RefinementReferenceCenter/Modular-MoPSS-Hardware/README.md

# Modular-MoPSS-Hardware

This repository contains the necessary files for 3D printing and to order the ModMoPSS module PCBs (eagle)

(This is a work in progress)

The contents of this repository are distributed under the GNU General Public License v3.0
