RefinementReferenceCenter/Modular-MoPSS-Hardware/PCB design files/ModMoPSS - door module/door fab/bom.xlsx

Comment | Designator | Footprint | JLCPCB Part #（optional）
red | 5V | CHIPLED_0805 | C84256
u33 | C1 | C0805 | C1740
u1 | C2 | C0805 | C49678
100u16v | C3 | SMC_C | C11375
100u16v | C4 | SMC_C | C11375
7805_TO252 | IC1 | TO252 | C233417
red | LED1 | CHIPLED_0805 | C84256
red | LED2 | CHIPLED_0805 | C84256
47k | R1 | R0805 | C17713
47k | R2 | R0805 | C17713
47k | R3 | R0805 | C17713
47k | R4 | R0805 | C17713
47k | R5 | R0805 | C17713
47k | R6 | R0805 | C17713
47k | R7 | R0805 | C17713
15k | R8 | R0805 | C17475
15k | R9 | R0805 | C17475
47k | R10 | R0805 | C17713
47k | R11 | R0805 | C17713
47k | R12 | R0805 | C17713
20k | R13 | R0805 | C4328
47k | R14 | R0805 | C17713
47k | R15 | R0805 | C17713
KH-3635-CAJ | S1 | KH-3635-CAJ | C530670
53261-04 | X1 | 53261-04 | C127368
53261-06 | X2 | 53261-06 | C99277
53261-04 | X3 | 53261-04 | C127368
53261-06 | X4 | 53261-06 | C99277
