RefinementReferenceCenter/Modular-MoPSS-Hardware/PCB design files/ModMoPSS - Hive module A/Hive fab/BOM.xlsx

Comment | Designator | Footprint | JLCPCB Part #（optional）
red | 3V3, 5V, 12V, ERR, STAT | CHIP-LED0805 | C84256
10k | R23, R26, R27 | R0805 | C17414
10u | C5 | C0805 | C15850
15k | R21 | R0805 | C17475
20k | R25 | R0805 | C4328
22k | R13 | R0805 | C17475
30k | R24 | R0805 | C17621
47k | R1, R2, R3, R4, R5, R6, R7, R8, R9, R10, R14, R15, R16, R17, R18, R19 | R0805 | C17713
4k7 | R11, R12, R20 | R0805 | C17673
53048-03 | J1, J2, J3, J4, J5, J6, J7 | 53048-03 | C505275
53048-04 | X1, X2, X3, X4, X5, X6, X7, X8 | 53048-04 | C588275
56k | R22 | R0805 | C17756
BS-08-B2AA002 | BAT | BS-08-B2AA002 | C964790
DC-042C-Z-2.5-A | PWR | DC-042C-Z-2.5-A | C706901
KH-3635-CAJ | B4 | KH-3635-CAJ | C530670
PUSH_BUTTON | B1, B2, B3 | PUSH_BUTTON | C127507
RJ45MAGJACK | ETH | LPJ4012AHNL | C910371
SSD1306 | SSD1306 | SSD1306 | C2718488
TF-011 | SD | TF-011 | C410352
u1 | C2, C3, C4 | C0805 | C49678
u33 | C1 | C0805 | C1740
uA7805CKCS | IC1 | TO252 | C233417
