RefinementReferenceCenter/Modular-MoPSS-Hardware/PCB design files/ModMoPSS - IR sender P/IR sen P fab/BOM.xlsx

Comment | Designator | Footprint | JLCPCB Part #（optional）
IR17-21C/TR8 | BOTTOM | CHIP-LED0805 | C131250
VSMB14940 | IRS1 | VSMB14940 | C511069
VSMB14940 | IRS2 | VSMB14940 | C511069
53261-04 | J1 | 53261-04 | C127368
PT12-21B/TR8 | PTS1 | PT12-21B/TR8 | C264383
PT12-21B/TR8 | PTS2 | PT12-21B/TR8 | C264383
1k 1/4W | R1 | R0805 | C412430
1k 1/4W | R2 | R0805 | C412430
2k | R3 | R0805 | C17604
2k | R4 | R0805 | C17604
IR17-21C/TR8 | TOP | CHIP-LED0805 | C131250
