RefinementReferenceCenter/Modular-MoPSS-Hardware/PCB design files/ModMoPSS - RFID module/RFID fab/BOM.xlsx

Comment | Designator | Footprint | JLCPCB Part #（optional）
red | 5V, READ1, READ2, STAT1, STAT2 | CHIPLED_0805 | C84256
100R 100V | R5, R7 | R1206 | C17901
100nF | C3, C4, C14, C26, C28, C30 | R1206 | C24497
100u 6.3V | C5, C6, C7, C10, C34, C35, C36, C40 | R1206 | C15008
10n | C8, C38 | R1206 | C1846
10nF | C15, C16, C25, C31 | R1206 | C1846
10u 16V | C9, C39 | R1206 | C2911415
1500p NP0 | C13, C20 | R1206 | C309500
1k | R6, R12, R14, R15 | R0805 | C17513
1k8 | R2, R4, R8, R11 | R0805 | C17398
1nF | C1, C2, C17, C27, C29, C32 | R1206 | C9196
1uF | C18, C33 | R1206 | C1848
20k | R13 | R0805 | C4328
390p NP0 100V | C21, C37 | R1206 | C527300
39p NP0 100V | C19, C24 | R1206 | C527287
3k3 | R1, R3, R9, R10 | R0805 | C26010
53048-02 | ANT1, ANT2 | 53048-02 | C505099
56p NP0 100V | C22, C44 | R1206 | C527289
5V6 | D1, D2 | SOD80C | C8062
7805_TO252 | IC2 | TO252 | C233417
EM4095 | IC3, IC4 | SO16 | C11356
JZ300HV | C23, C41 | JZ300HV
KH-3635-CAJ | S1, S2 | KH-3635-CAJ | C530670
LT1761ES5-5 | IC1, IC5 | TSOT23-5 | C117230
u1 | C12 | C0805 | C49678
u33 | C11 | C0805 | C1740
