RefinementReferenceCenter/Modular-MoPSS-Hardware/PCB design files/ModMoPSS - IR receiver P/IR rec P fab/BOM.xlsx

Comment | Designator | Footprint | JLCPCB Part #（optional）
PT11-21C/L41/TR8 | BOTTOM | CHIPLED_1206 | C16746
VSMB14940 | IRS1 | VSMB14940 | C511069
VSMB14940 | IRS2 | VSMB14940 | C511069
PT12-21B/TR8 | PTS1 | PT12-21B/TR8 | C264383
PT12-21B/TR8 | PTS2 | PT12-21B/TR8 | C264383
1k 1/4W | R1 | R0805 | C412430
1k 1/4W | R2 | R0805 | C412430
PT11-21C/L41/TR8 | TOP | CHIPLED_1206 | C16746
53261-06 | X1 | 53261-06 | C99277
