RefinementReferenceCenter/Modular-MoPSS-Hardware/3D print files/ModMoPSS case/RFIDcase.stl

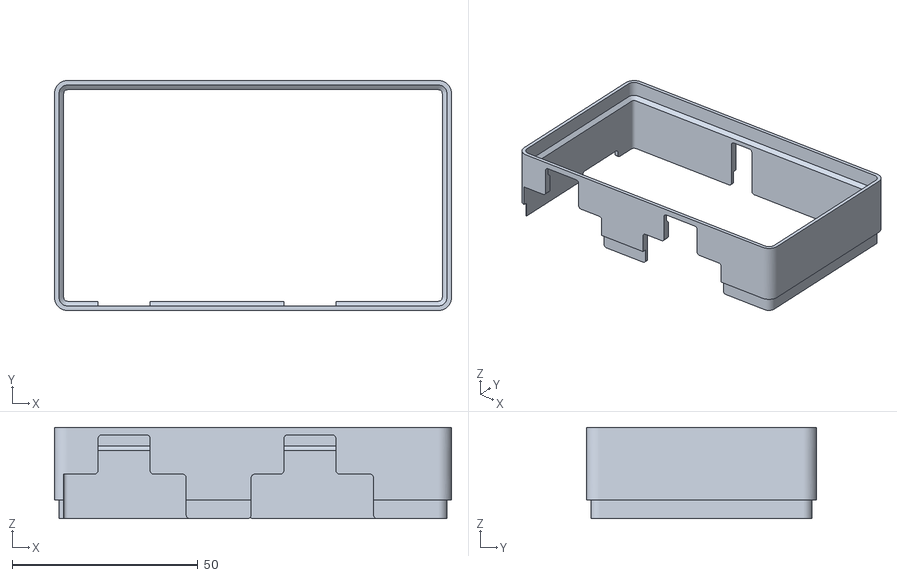
[picture p1: CAD file, 2023-12-20]
3D print files/ModMoPSS case/RFIDcase.stl
107.0 x 62.0 x 24.6
