RefinementReferenceCenter/Modular-MoPSS-Hardware/3D print files/ModMoPSS Gate parts/Motorholder 40mm.stl

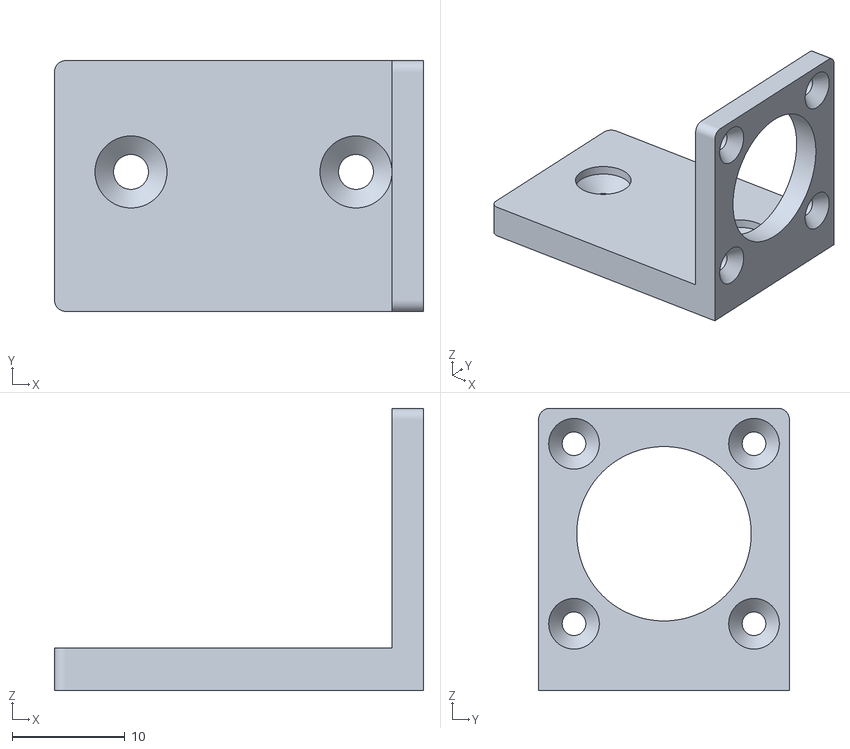
[picture p2: CAD file, 2023-11-22]
3D print files/ModMoPSS Gate parts/Motorholder 40mm.stl
32.8 x 22.3 x 25.1
