RefinementReferenceCenter/Modular-MoPSS-Hardware/3D print files/ModMoPSS case/Buttonextension.stl

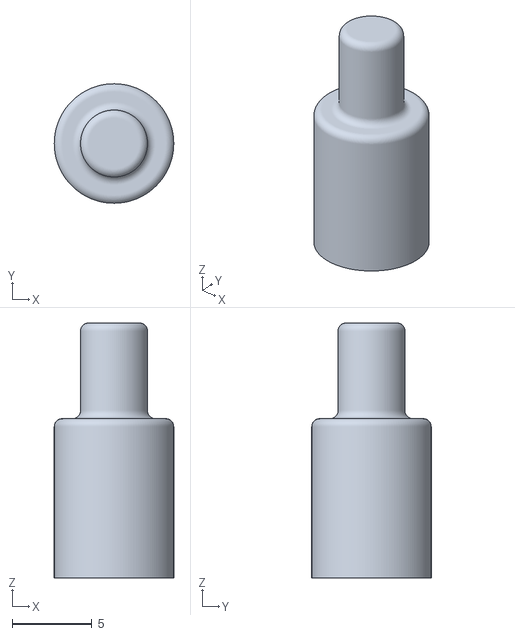
[picture p3: CAD file, 2023-02-16]
3D print files/ModMoPSS case/Buttonextension.stl
7.50 x 7.50 x 16.0
