RefinementReferenceCenter/Modular-MoPSS-Hardware/3D print files/ModMoPSS Gate parts/clamp 40mm.stl

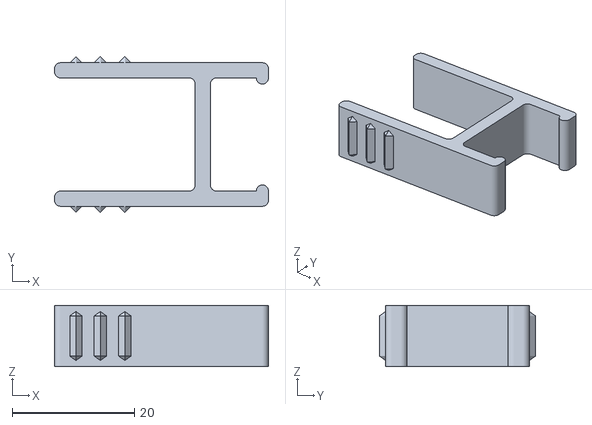
[picture p4: CAD file, 2023-11-22]
3D print files/ModMoPSS Gate parts/clamp 40mm.stl
35.0 x 25.5 x 10.0
