RefinementReferenceCenter/Modular-MoPSS-Hardware/3D print files/ModMoPSS case/Bottom.stl

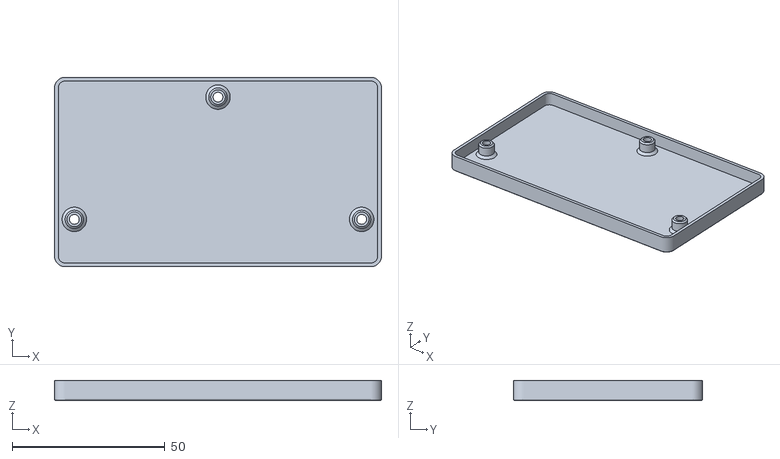
[picture p5: CAD file, 2023-02-14]
3D print files/ModMoPSS case/Bottom.stl
107.0 x 62.0 x 6.60
