RefinementReferenceCenter/Modular-MoPSS-Hardware/3D print files/ModMoPSS Gate parts/Door A 40mm.stl

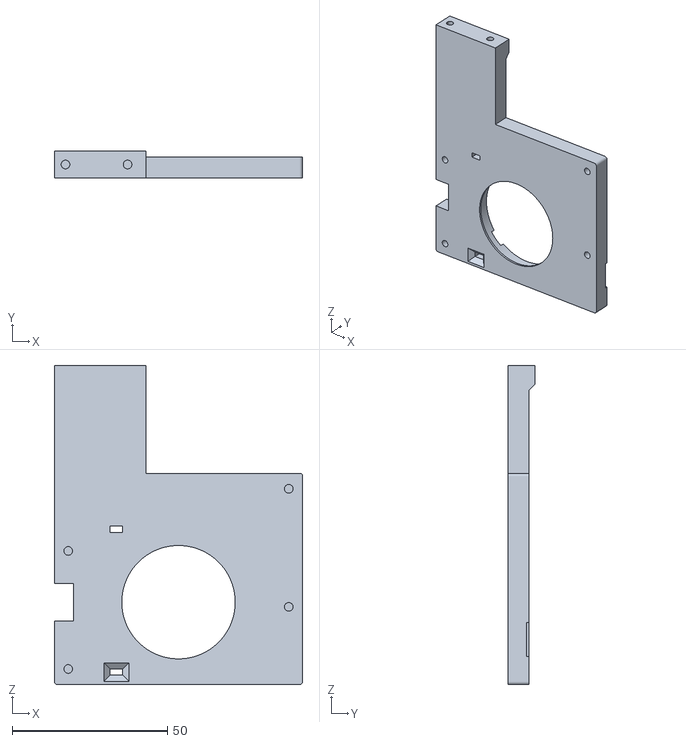
[picture p6: CAD file, 2023-11-22]
3D print files/ModMoPSS Gate parts/Door A 40mm.stl
80.0 x 8.80 x 102.7
