RefinementReferenceCenter/Modular-MoPSS-Hardware/3D print files/ModMoPSS case/Steppercase.stl

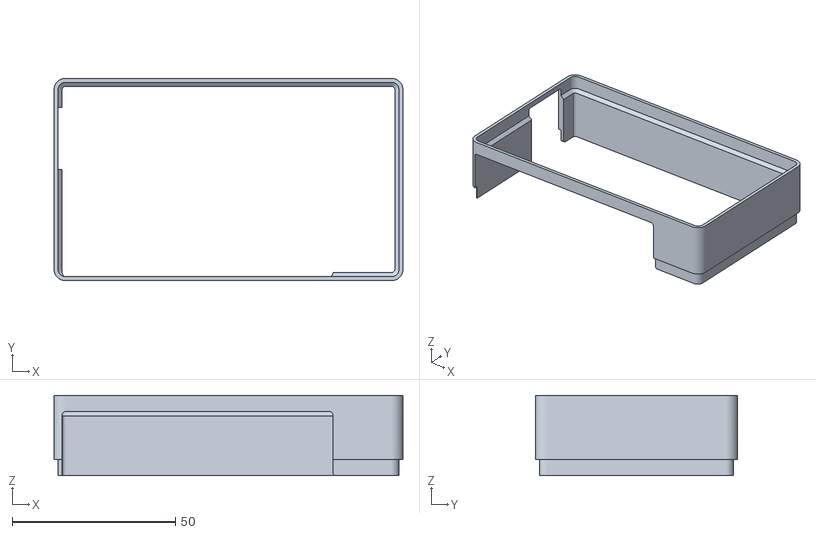
[picture p7: CAD file, 2023-02-14]
3D print files/ModMoPSS case/Steppercase.stl
107.0 x 62.0 x 24.6
