RefinementReferenceCenter/Modular-MoPSS-Hardware/3D print files/ModMoPSS Gate parts/Door 40mm.stl

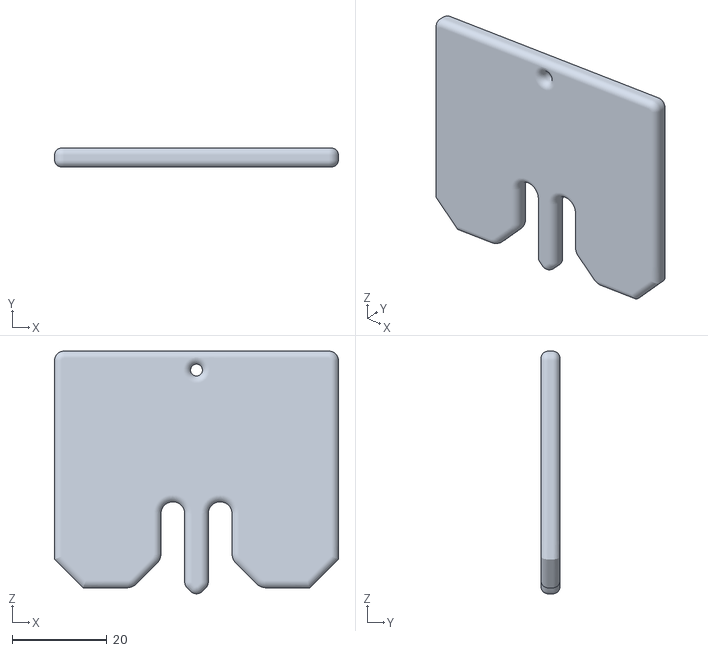
[picture p8: CAD file, 2023-11-22]
3D print files/ModMoPSS Gate parts/Door 40mm.stl
60.0 x 4.00 x 51.3
