RefinementReferenceCenter/Modular-MoPSS-Hardware/3D print files/ModMoPSS Gate parts/Door B 40mm.stl

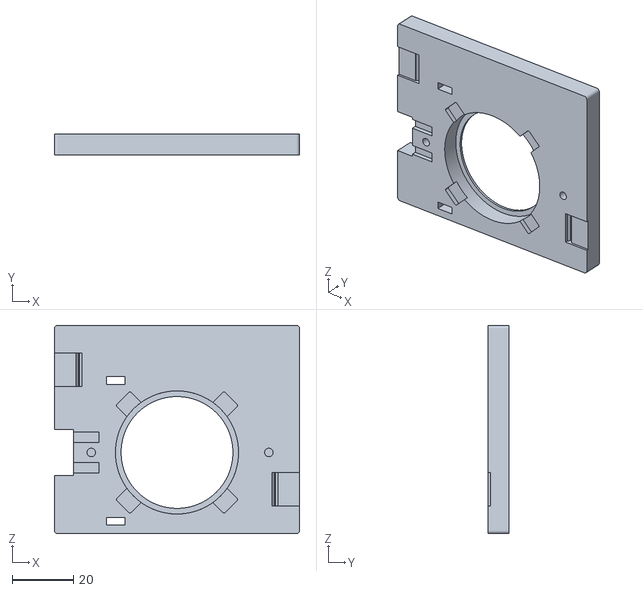
[picture p10: CAD file, 2023-11-22]
3D print files/ModMoPSS Gate parts/Door B 40mm.stl
80.0 x 6.80 x 68.0
