RefinementReferenceCenter/Modular-MoPSS-Hardware/3D print files/ModMoPSS Gate parts/door 30mm.stl

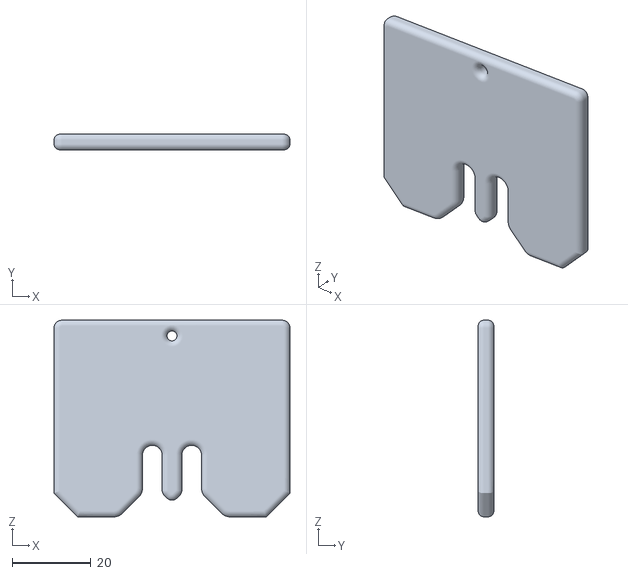
[picture p12: CAD file, 2023-01-30]
3D print files/ModMoPSS Gate parts/door 30mm.stl
60.0 x 4.00 x 50.0
