RefinementReferenceCenter/Modular-MoPSS-Hardware/3D print files/ModMoPSS Gate parts/door part D.stl

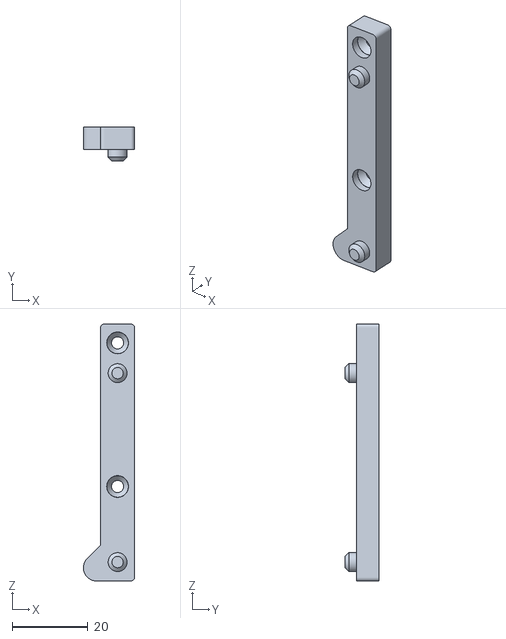
[picture p13: CAD file, 2023-01-30]
3D print files/ModMoPSS Gate parts/door part D.stl
13.6 x 9.00 x 68.0
