RefinementReferenceCenter/Modular-MoPSS-Hardware/3D print files/ModMoPSS Gate parts/door part B 30mm.stl

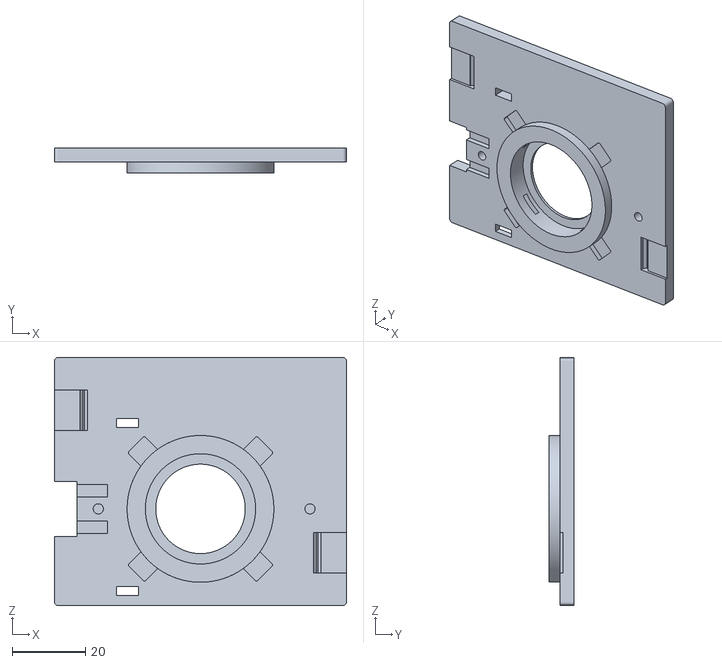
[picture p14: CAD file, 2023-01-30]
3D print files/ModMoPSS Gate parts/door part B 30mm.stl
80.0 x 6.80 x 68.0
