RefinementReferenceCenter/Modular-MoPSS-Hardware/3D print files/ModMoPSS Gate parts/spool.stl

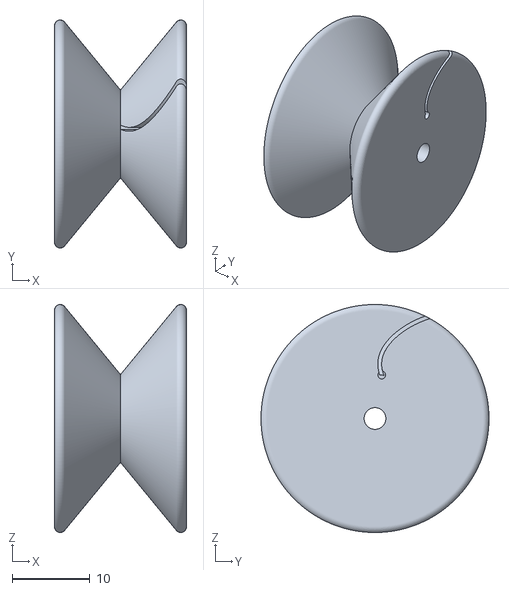
[picture p15: CAD file, 2023-01-30]
3D print files/ModMoPSS Gate parts/spool.stl
17.0 x 29.3 x 29.3
