RefinementReferenceCenter/Modular-MoPSS-Hardware/3D print files/ModMoPSS Gate parts/door part A 30mm.stl

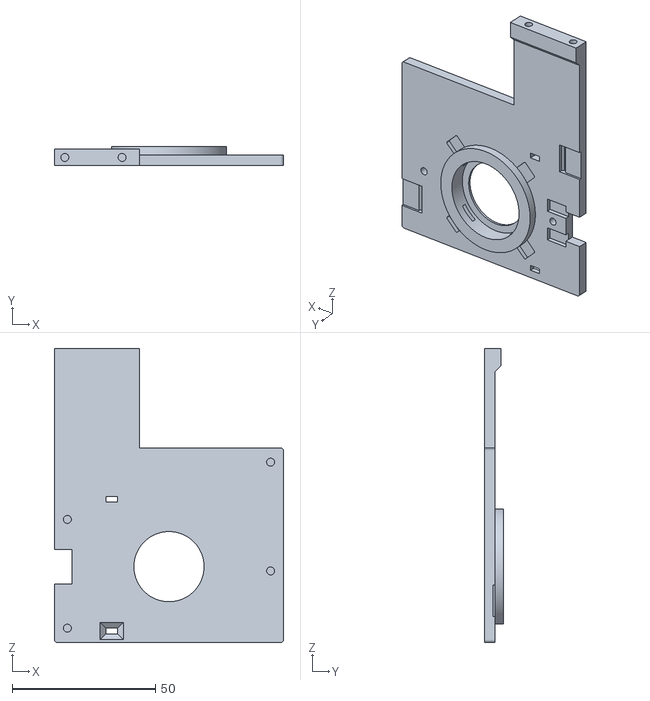
[picture p16: CAD file, 2023-01-30]
3D print files/ModMoPSS Gate parts/door part A 30mm.stl
80.0 x 6.80 x 102.7
