RefinementReferenceCenter/Modular-MoPSS-Hardware/3D print files/ModMoPSS Gate parts/clamp 30mm.stl

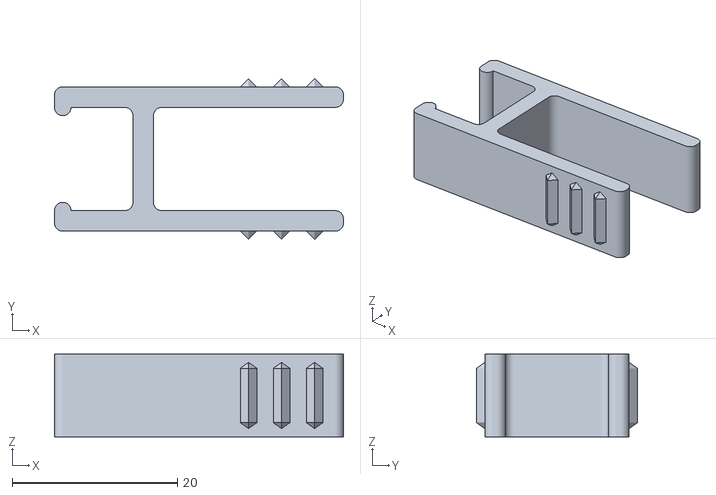
[picture p17: CAD file, 2023-01-30]
3D print files/ModMoPSS Gate parts/clamp 30mm.stl
35.0 x 19.5 x 10.0
