RefinementReferenceCenter/Modular-MoPSS-Hardware/(list of files, cad)

Other CAD files:
3D print files/ModMoPSS Gate parts/door part C.stl
3D print files/ModMoPSS Gate parts/motorholder 30mm.stl
