RefinementReferenceCenter/Modular-MoPSS-Hardware/PCB design files/ModMoPSS - RFID module/rfid.brd

## EAGLE design PCB design files/ModMoPSS - RFID module/rfid.brd (2025-07-09)

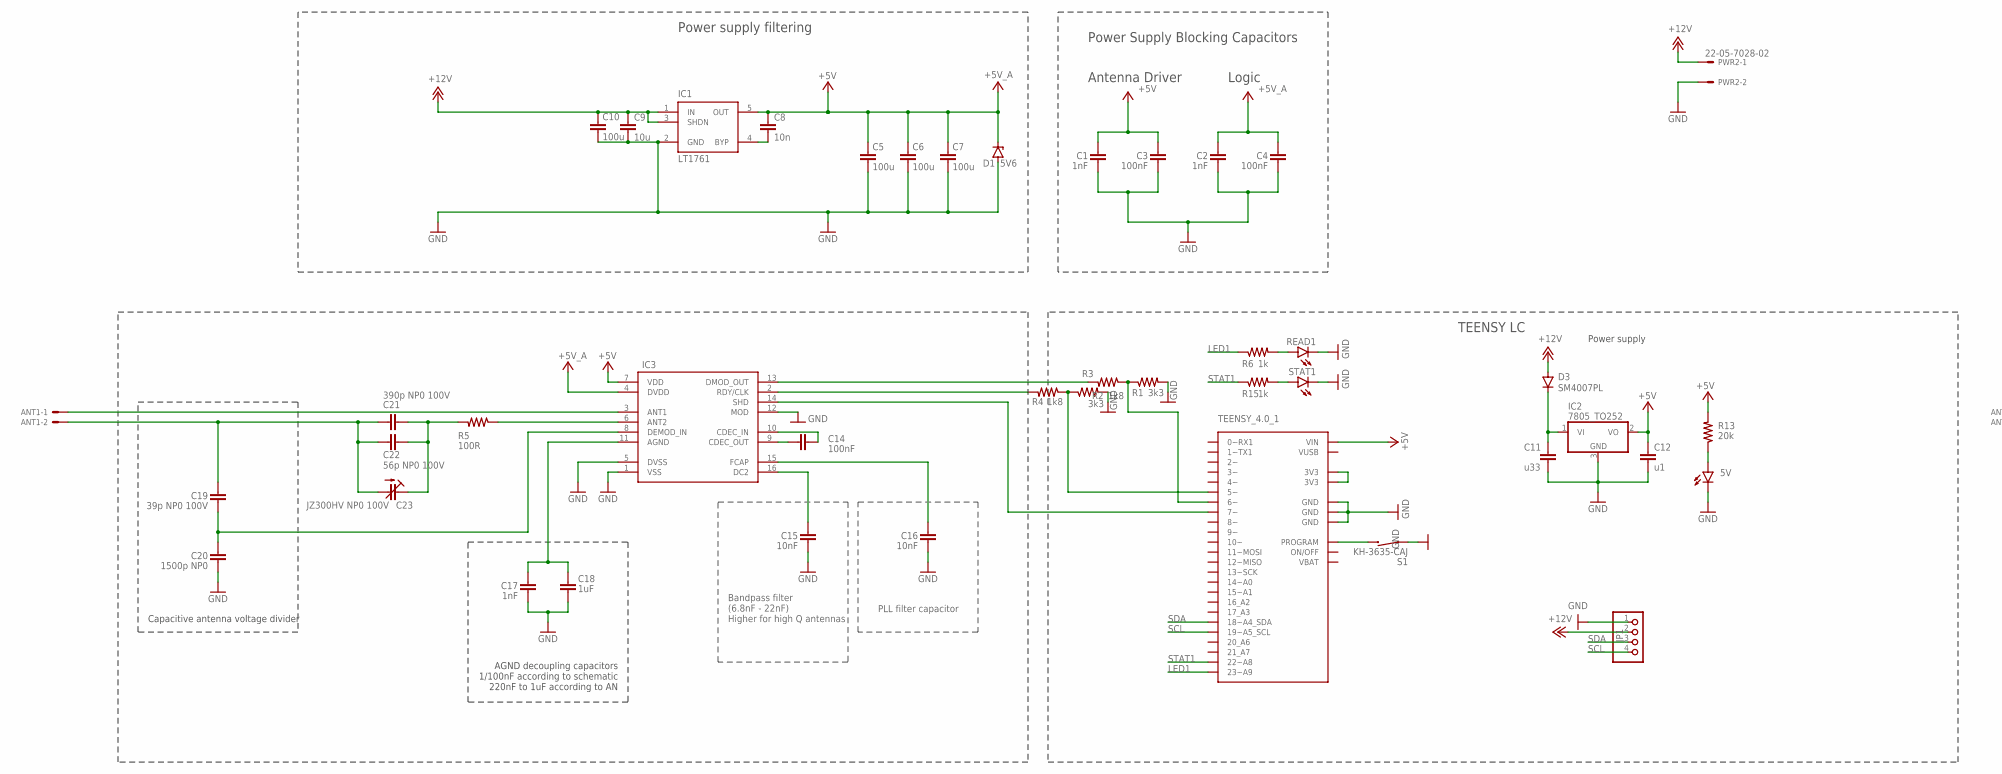
[picture p18: schematic rfid.sch, part in row 1, column 1]

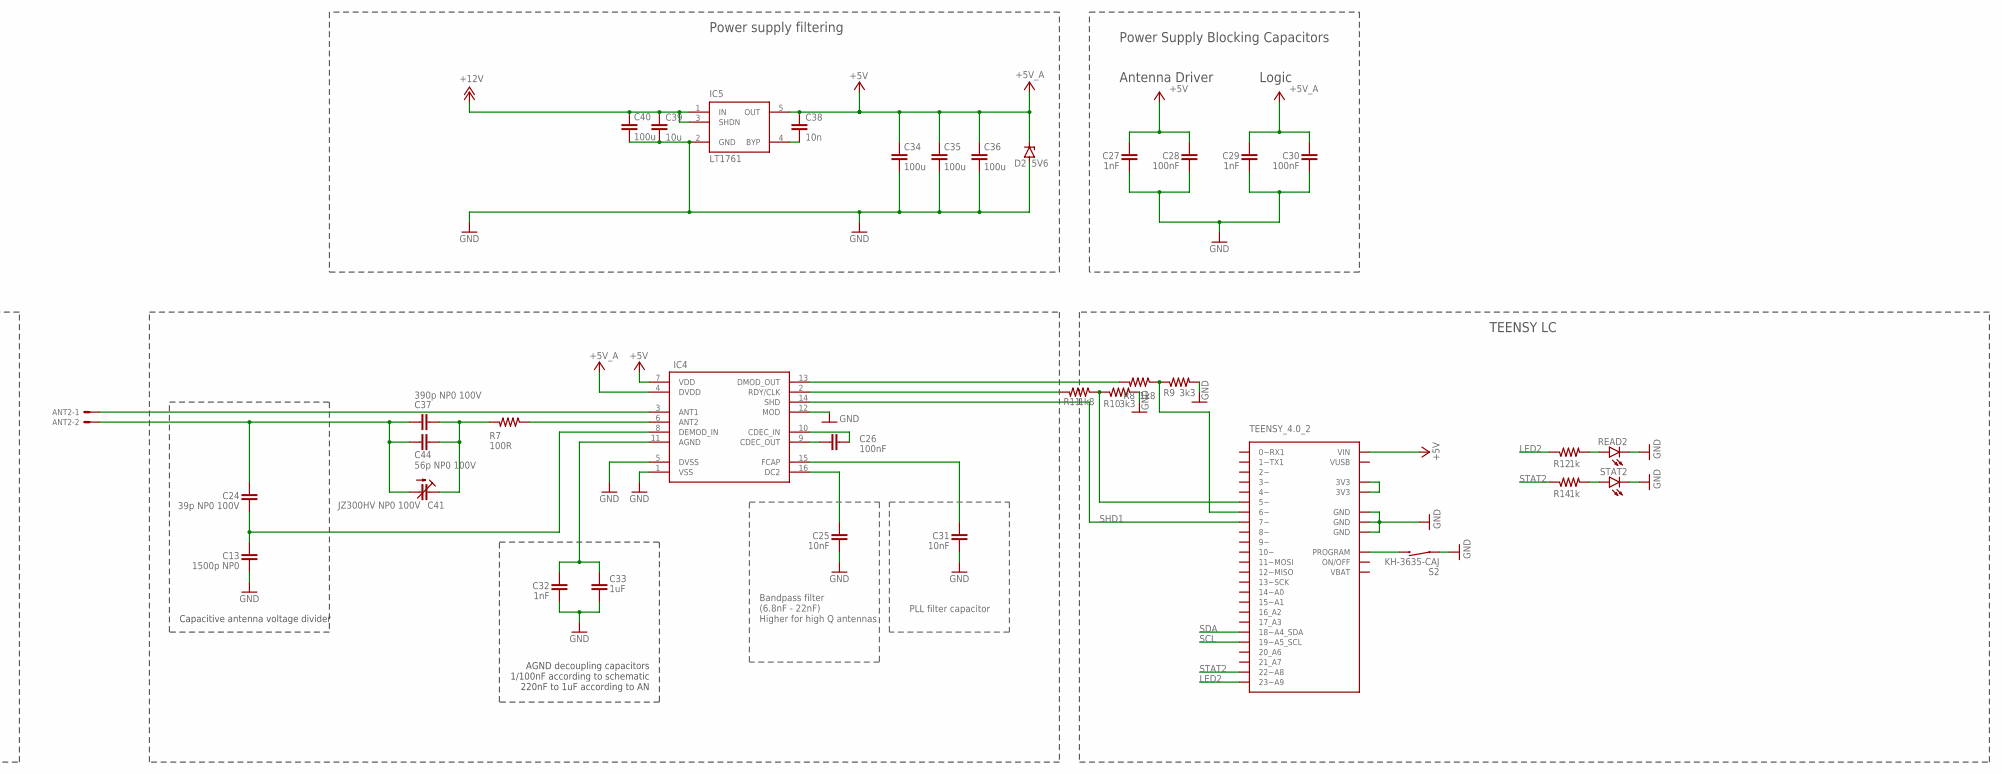
[picture p19: schematic rfid.sch, part in row 1, column 2]

Parts:
5V: LEDCHIPLED_0805; CHIPLED_0805
ANT1, ANT2: 53261-02
C1, C2, C17, C27, C29, C32: 1nF; R1206
C3, C4, C14, C26, C28, C30: 100nF; R1206
C5, C6, C7, C10, C34, C35, C36, C40: 100u; R1206
C8, C38: 10n; R1206
C9, C39: 10u; R1206
C11: u33; C0805
C12: u1; C0805
C13, C20: 1500p NP0; R1206
C15, C16, C25, C31: 10nF; R1206
C18, C33: 1uF; R1206
C19, C24: 39p NP0 100V; R1206
C21, C37: 390p NP0 100V; R1206
C22, C44: 56p NP0 100V; R1206
C23, C41: JZ300HV NP0 100V; JZ300HV
D1, D2: 5V6; SOD80C
D3: SM4007PL; SOD-123_MINI-SMA
IC1, IC5: LT1761; TSOT23-5
IC2: 7805_TO252; TO252
IC3, IC4: EM4095; SO16
JP1: PINHD-1X4; 1X04
PWR2: 22-05-7028-02; 7395-02
R1, R3, R9, R10: 3k3; R0805
R2, R4, R8, R11: 1k8; R0805
R5, R7: 100R; R1206
R6, R12, R14, R15: 1k; R0805
R13: 20k; R0805
READ1, READ2: LEDCHIPLED_0805; CHIPLED_0805
S1, S2: KH-3635-CAJ
STAT1, STAT2: LEDCHIPLED_0805; CHIPLED_0805
TEENSY_4.0_1, TEENSY_4.0_2: TEENSY40

Connections:
+5V: C1.2, C2.2, C3.2, C4.2, C5.1, C6.1, C7.1, C8.1, C12.1, C27.2, C28.2, C29.2, C30.2, C34.1, C35.1, C36.1, C38.1, D1.C, D2.C, IC1.5 (OUT), IC2.2 (VO), IC3.4 (DVDD), IC3.7 (VDD), IC4.4 (DVDD), IC4.7 (VDD), IC5.5 (OUT), R13.2, TEENSY_4.0_1.VIN, TEENSY_4.0_2.VIN
+12V: C9.1, C10.1, C39.1, C40.1, D3.A, IC1.1 (IN), IC1.3 (SHDN), IC5.1 (IN), IC5.3 (SHDN), JP1.2, PWR2.1
AGND: C17.2, C18.2, IC3.11 (AGND)
AGND1: C32.2, C33.2, IC4.11 (AGND)
ANT2: IC3.6 (ANT2), R5.1
ANT3: IC4.6 (ANT2), R7.1
ANT4: ANT2.1, IC4.3 (ANT1)
CDEC_IN: C14.2, IC3.10 (CDEC_IN)
CDEC_IN1: C26.2, IC4.10 (CDEC_IN)
CDEC_OUT: C14.1, IC3.9 (CDEC_OUT)
CDEC_OUT1: C26.1, IC4.9 (CDEC_OUT)
DC1: C25.1, IC4.16 (DC2)
DC2: C15.1, IC3.16 (DC2)
DMODI: C19.1, C20.2, IC3.8 (DEMOD_IN)
DMODI1: C13.2, C24.1, IC4.8 (DEMOD_IN)
FCAP: C16.1, IC3.15 (FCAP)
FCAP1: C31.1, IC4.15 (FCAP)
GND: 5V.C, C1.1, C2.1, C3.1, C4.1, C5.2, C6.2, C7.2, C9.2, C10.2, C11.2, C12.2, C13.1, C15.2, C16.2, C17.1, C18.1, C20.1, C25.2, C27.1, C28.1, C29.1, C30.1, C31.2, C32.1, C33.1, C34.2, C35.2, C36.2, C39.2, C40.2, D1.A, D2.A, IC1.2 (GND), IC2.3 (GND), IC3.1 (VSS), IC3.5 (DVSS), IC3.12 (MOD), IC4.1 (VSS), IC4.5 (DVSS), IC4.12 (MOD), IC5.2 (GND), JP1.1, PWR2.2, R1.2, R3.2, R9.2, R10.2, READ1.C, READ2.C, S1.P$1 (1), S2.P$1 (1), STAT1.C, STAT2.C, TEENSY_4.0_1.GND, TEENSY_4.0_1.GND@1 (GND), TEENSY_4.0_1.GND@2 (GND), TEENSY_4.0_2.GND, TEENSY_4.0_2.GND@1 (GND), TEENSY_4.0_2.GND@2 (GND)
LED1: R6.1, TEENSY_4.0_1.23 (23~A9)
LED2: R12.1, TEENSY_4.0_2.23 (23~A9)
unnamed: R6.2, READ1.A
unnamed: R3.1, R4.1, TEENSY_4.0_1.5 (5~)
unnamed: ANT2.2, C24.2, C37.1, C41.P$1 (A), C44.1
unnamed: C37.2, C41.P$2 (E), C44.2, R7.2
unnamed: C21.2, C22.2, C23.P$2 (E), R5.2
unnamed: R1.1, R2.1, TEENSY_4.0_1.6 (6~)
unnamed: C8.2, IC1.4 (BYP)
unnamed: S1.P$2 (2), TEENSY_4.0_1.PROG (PROGRAM)
unnamed: C38.2, IC5.4 (BYP)
unnamed: TEENSY_4.0_1.3V3, TEENSY_4.0_1.3V3@2 (3V3)
unnamed: R8.1, R9.1, TEENSY_4.0_2.6 (6~)
unnamed: R10.1, R11.1, TEENSY_4.0_2.5 (5~)
unnamed: R12.2, READ2.A
unnamed: ANT1.2, C19.2, C21.1, C22.1, C23.P$1 (A)
unnamed: IC3.14 (SHD), TEENSY_4.0_1.7 (7~)
unnamed: S2.P$2 (2), TEENSY_4.0_2.PROG (PROGRAM)
unnamed: TEENSY_4.0_2.3V3, TEENSY_4.0_2.3V3@2 (3V3)
unnamed: R14.2, STAT2.A
unnamed: R15.2, STAT1.A
unnamed: ANT1.1, IC3.3 (ANT1)
unnamed: C11.1, D3.C, IC2.1 (VI)
unnamed: IC4.13 (DMOD_OUT), R8.2
unnamed: IC3.2 (RDY/CLK), R4.2
unnamed: IC3.13 (DMOD_OUT), R2.2
unnamed: 5V.A, R13.1
unnamed: IC4.2 (RDY/CLK), R11.2
SCL: JP1.4, TEENSY_4.0_1.19 (19~A5_SCL), TEENSY_4.0_2.19 (19~A5_SCL)
SDA: JP1.3, TEENSY_4.0_1.18 (18~A4_SDA), TEENSY_4.0_2.18 (18~A4_SDA)
SHD1: IC4.14 (SHD), TEENSY_4.0_2.7 (7~)
STAT1: R15.1, TEENSY_4.0_1.22 (22~A8)
STAT2: R14.1, TEENSY_4.0_2.22 (22~A8)

Notes on the sheet:
Power supply filtering
Antenna Driver
Logic
AGND decoupling capacitors 1/100nF according to schematic 220nF to 1uF according to AN
Capacitive antenna voltage divider
Bandpass filter (6.8nF - 22nF) Higher for high Q antennas
PLL filter capacitor
Power Supply Blocking Capacitors
TEENSY LC
Power supply

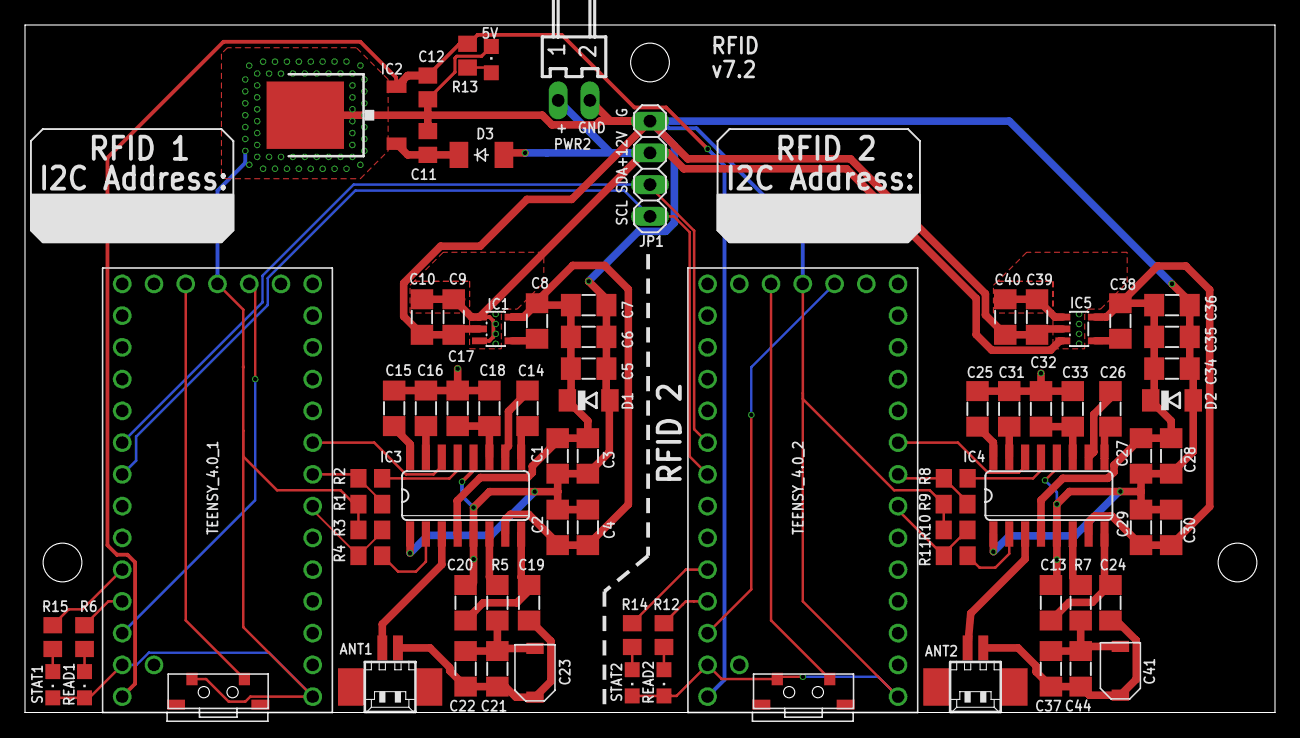
[picture p20: board rfid.brd from above]

Board: 2 copper layers, 100.0 x 55.0 mm, 78 parts (0 on the bottom side), 51 nets.
