RefinementReferenceCenter/Modular-MoPSS-Hardware/PCB design files/ModMoPSS - Hive module A/hive_module.brd

## EAGLE design PCB design files/ModMoPSS - Hive module A/hive_module.brd (2023-01-10)

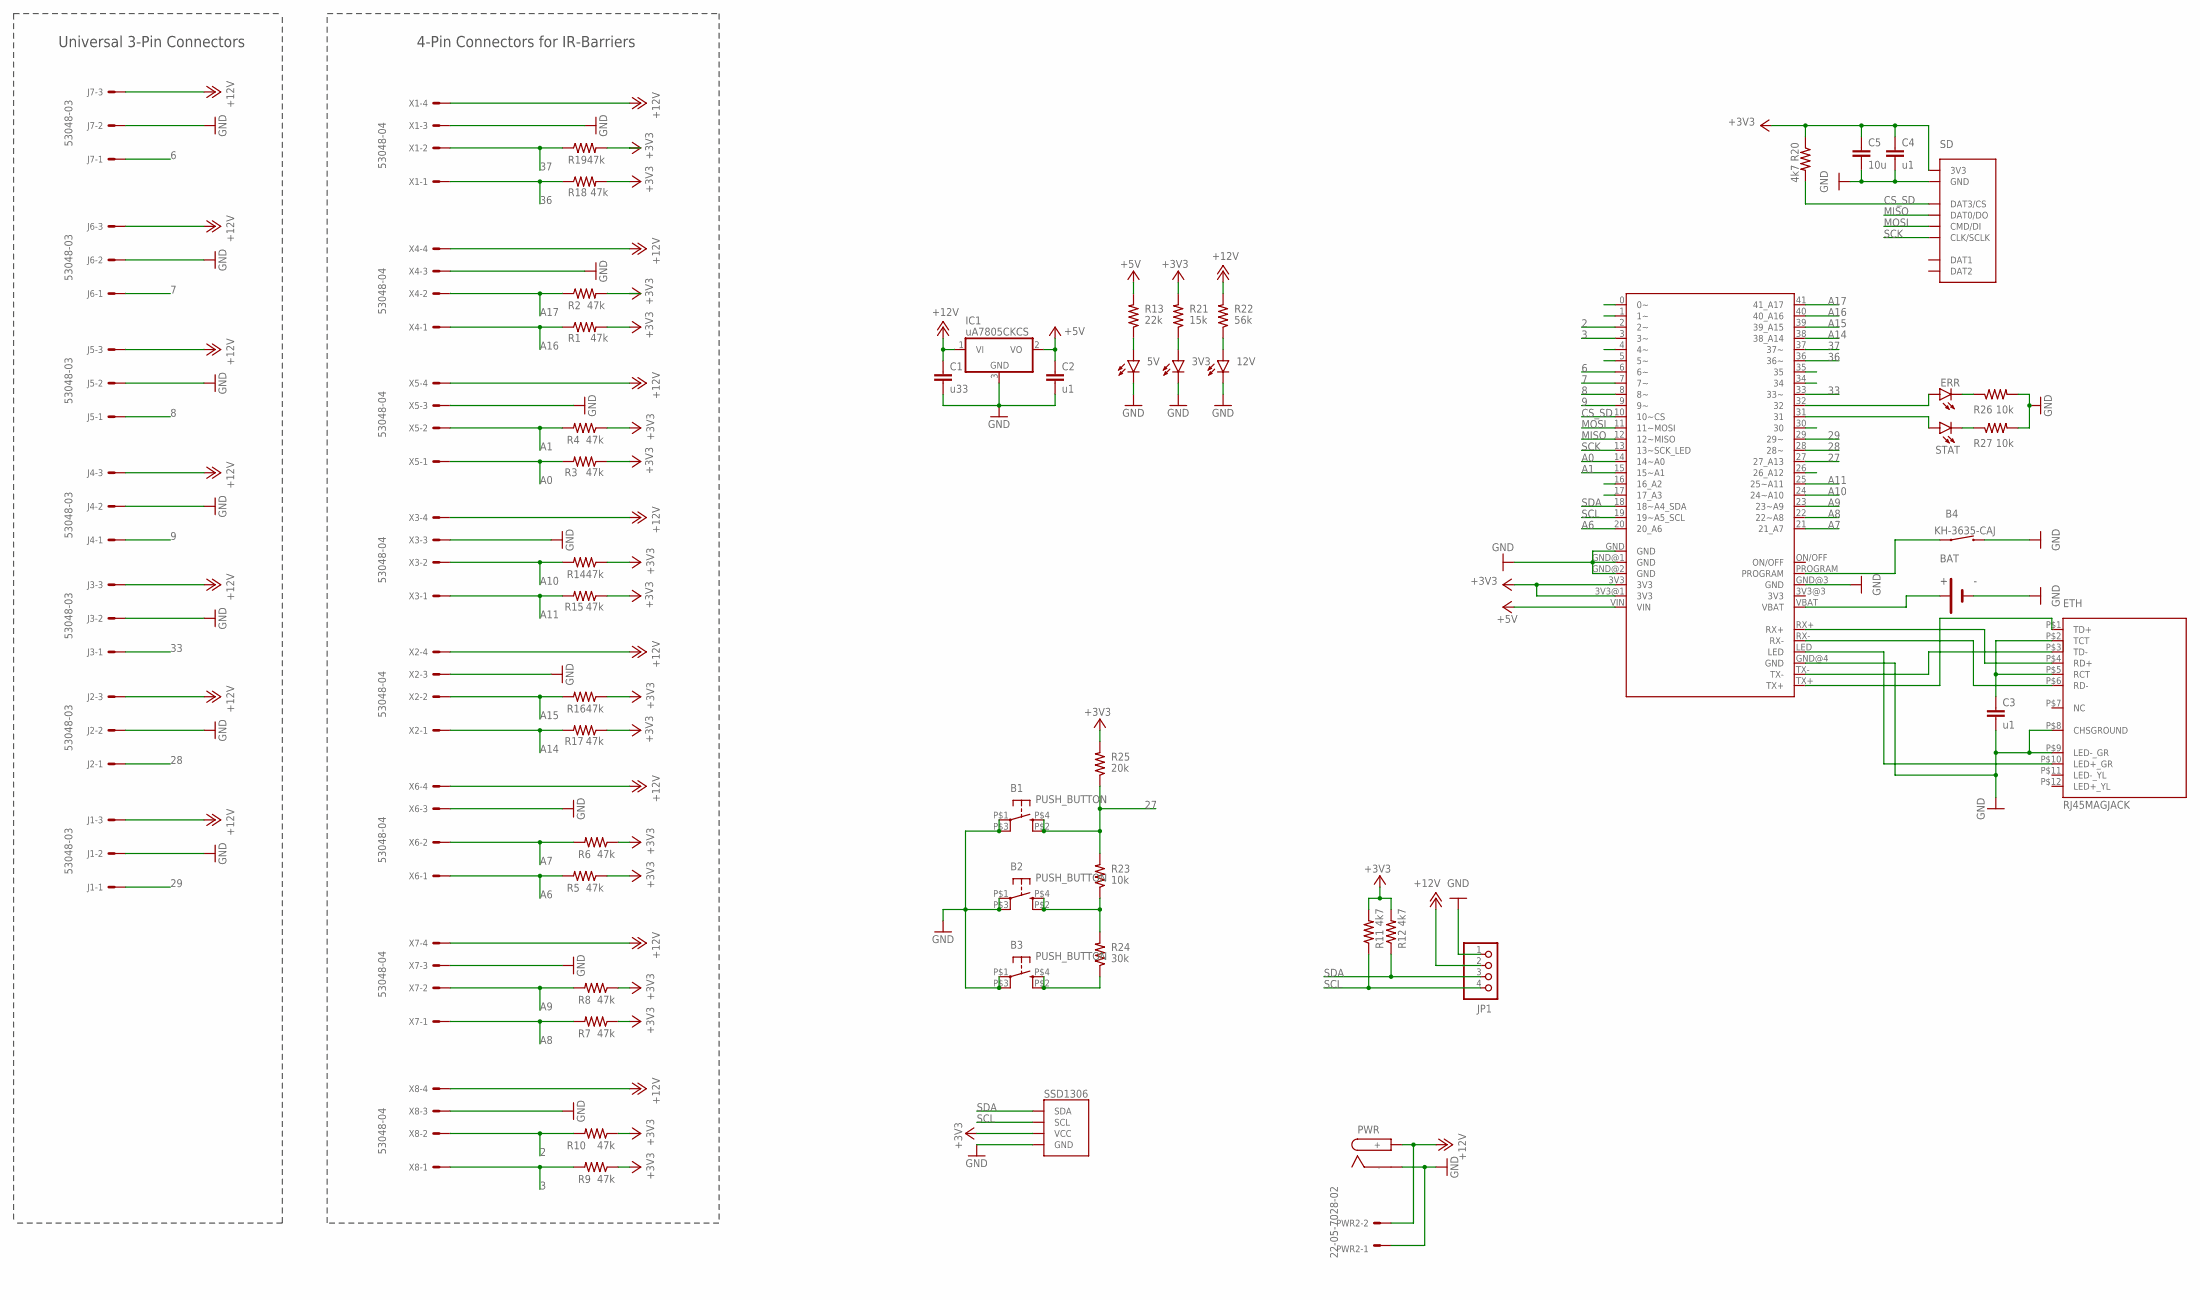
[picture p21: schematic hive_module.sch]

Parts:
3V3, 5V, 12V: LEDCHIP-LED0805; CHIP-LED0805
B1, B2, B3: PUSH_BUTTON
B4: KH-3635-CAJ
BAT: BS-08-B2AA002
C1: u33; C0805
C2, C3, C4: u1; C0805
C5: 10u; C0805
ERR: LEDCHIP-LED0805; CHIP-LED0805
ETH: RJ45MAGJACK; LPJ4012AHNL
IC1: uA7805CKCS; TO252
J1, J2, J3, J4, J5, J6, J7: 53048-03
JP1: PINHD-1X4; 1X04
PWR: DC-042C-Z-2.5-A
PWR2: 22-05-7028-02; 7395-02
R1, R2, R3, R4, R5, R6, R7, R8, R9, R10, R14, R15, R16, R17, R18, R19: 47k; R0805
R11, R12, R20: 4k7; R0805
R13: 22k; R0805
R21: 15k; R0805
R22: 56k; R0805
R23, R26, R27: 10k; R0805
R24: 30k; R0805
R25: 20k; R0805
SD: TF-011
SSD1306: SSD1306
STAT: LEDCHIP-LED0805; CHIP-LED0805
U$1: TEENSY41
X1, X2, X3, X4, X5, X6, X7, X8: 53048-04

Connections:
2: R10.2, U$1.2 (2~), X8.2
3: R9.2, U$1.3 (3~), X8.1
6: J7.1, U$1.6 (6~)
7: J6.1, U$1.7 (7~)
8: J5.1, U$1.8 (8~)
9: J4.1, U$1.9 (9~)
27: B1.P$2 (S1), B1.P$4 (S), R23.2, R25.1, U$1.27 (27_A13)
28: J2.1, U$1.28 (28~)
29: J1.1, U$1.29 (29~)
33: J3.1, U$1.33 (33~)
36: R18.1, U$1.36 (36~), X1.1
37: R19.1, U$1.37 (37~), X1.2
+3V3: C4.1, C5.1, R1.2, R2.2, R3.1, R4.1, R5.1, R6.1, R7.1, R8.1, R9.1, R10.1, R11.2, R12.2, R14.1, R15.1, R16.1, R17.1, R18.2, R19.2, R20.1, R21.2, R25.2, SD.P$4 (3V3), SSD1306.P$2 (VCC), U$1.3V3, U$1.3V3@1 (3V3)
+5V: C2.1, IC1.2 (VO), R13.2, U$1.VIN
+12V: C1.1, IC1.1 (VI), J1.3, J2.3, J3.3, J4.3, J5.3, J6.3, J7.3, JP1.2, PWR.P$6 (+), PWR2.2, R22.2, X1.4, X2.4, X3.4, X4.4, X5.4, X6.4, X7.4, X8.4
A0: R3.2, U$1.14 (14~A0), X5.1
A1: R4.2, U$1.15 (15~A1), X5.2
A6: R5.2, U$1.20 (20_A6), X6.1
A7: R6.2, U$1.21 (21_A7), X6.2
A8: R7.2, U$1.22 (22~A8), X7.1
A9: R8.2, U$1.23 (23~A9), X7.2
A10: R14.2, U$1.24 (24~A10), X3.2
A11: R15.2, U$1.25 (25~A11), X3.1
A14: R17.2, U$1.38 (38_A14), X2.1
A15: R16.2, U$1.39 (39_A15), X2.2
A16: R1.1, U$1.40 (40_A16), X4.1
A17: R2.1, U$1.41 (41_A17), X4.2
CS_SD: R20.2, SD.P$2 (DAT3/CS), U$1.10 (10~CS)
GND: 3V3.C, 5V.C, 12V.C, B1.P$1, B1.P$3 (P1), B2.P$1, B2.P$3 (P1), B3.P$1, B3.P$3 (P1), B4.P$2 (2), BAT.-, C1.2, C2.2, C3.2, C4.2, C5.2, ETH.P$8 (CHSGROUND), ETH.P$9 (LED-_GR), IC1.3 (GND), J1.2, J2.2, J3.2, J4.2, J5.2, J6.2, J7.2, JP1.1, PWR.P$1 (-), PWR.P$2 (-), PWR.P$3 (-), PWR.P$4 (-), PWR.P$5 (-), PWR2.1, R26.2, R27.2, SD.P$6 (GND), SD.P$9 (GND), SD.P$10 (GND), SD.P$11 (GND), SD.P$12 (GND), SSD1306.P$1 (GND), U$1.GND, U$1.GND@1 (GND), U$1.GND@2 (GND), U$1.GND@3 (GND), U$1.GND@4 (GND), X1.3, X2.3, X3.3, X4.3, X5.3, X6.3, X7.3, X8.3
MISO: SD.P$7 (DAT0/DO), U$1.12 (12~MISO)
MOSI: SD.P$3 (CMD/DI), U$1.11 (11~MOSI)
unnamed: ETH.P$1 (TD+), U$1.TX+
unnamed: ETH.P$3 (TD-), U$1.TX-
unnamed: 3V3.A, R21.1
unnamed: ETH.P$6 (RD-), U$1.RX-
unnamed: ETH.P$4 (RD+), U$1.RX+
unnamed: ETH.P$10 (LED+_GR), U$1.LED
unnamed: 12V.A, R22.1
unnamed: C3.1, ETH.P$2 (TCT), ETH.P$5 (RCT)
unnamed: BAT.+, U$1.VBAT
unnamed: B4.P$1 (1), U$1.PROGRAM
unnamed: ERR.A, U$1.32
unnamed: B3.P$2 (S1), B3.P$4 (S), R24.1
unnamed: B2.P$2 (S1), B2.P$4 (S), R23.1, R24.2
unnamed: ERR.C, R26.1
unnamed: R27.1, STAT.C
unnamed: STAT.A, U$1.31
unnamed: 5V.A, R13.1
SCK: SD.P$5 (CLK/SCLK), U$1.13 (13~SCK_LED)
SCL: JP1.4, R11.1, SSD1306.P$3 (SCL), U$1.19 (19~A5_SCL)
SDA: JP1.3, R12.1, SSD1306.P$4 (SDA), U$1.18 (18~A4_SDA)

Notes on the sheet:
4-Pin Connectors for IR-Barriers
Universal 3-Pin Connectors

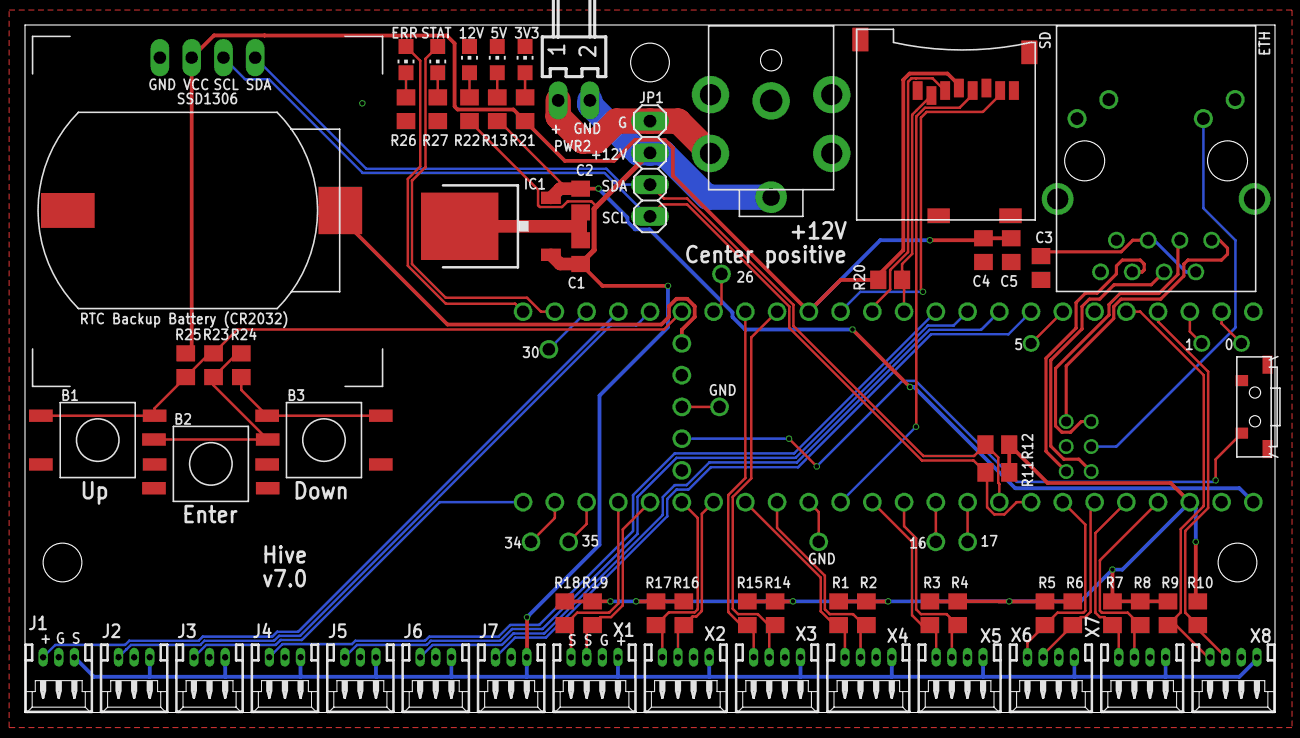
[picture p22: board hive_module.brd from above]

Board: 2 copper layers, 100.0 x 55.0 mm, 65 parts (0 on the bottom side), 51 nets.
