RefinementReferenceCenter/Modular-MoPSS-Hardware/PCB design files/ModMoPSS - IR receiver X/ModMoPSS - IR receiver.brd

## EAGLE design PCB design files/ModMoPSS - IR receiver X/ModMoPSS - IR receiver.brd (2023-01-10)

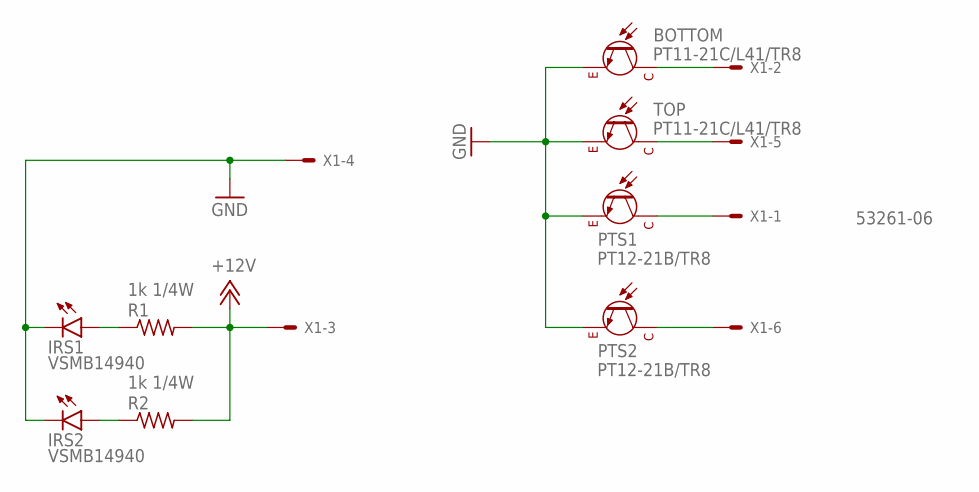
[picture p23: schematic ModMoPSS - IR receiver.sch]

Parts:
BOTTOM: PT11-21C/L41/TR8; CHIPLED_1206
IRS1, IRS2: VSMB14940
PTS1, PTS2: PT12-21B/TR8
R1, R2: 1k 1/4W; R0805
TOP: PT11-21C/L41/TR8; CHIPLED_1206
X1: 53261-06

Connections:
+12V: R1.2, R2.2, X1.3
GND: BOTTOM.A (E), IRS1.P$2 (C), IRS2.P$2 (C), PTS1.P$2 (E), PTS2.P$2 (E), TOP.A (E), X1.4
unnamed: BOTTOM.C, X1.2
unnamed: PTS1.P$1 (C), X1.1
unnamed: TOP.C, X1.5
unnamed: IRS2.P$1 (A), R2.1
unnamed: PTS2.P$1 (C), X1.6
unnamed: IRS1.P$1 (A), R1.1

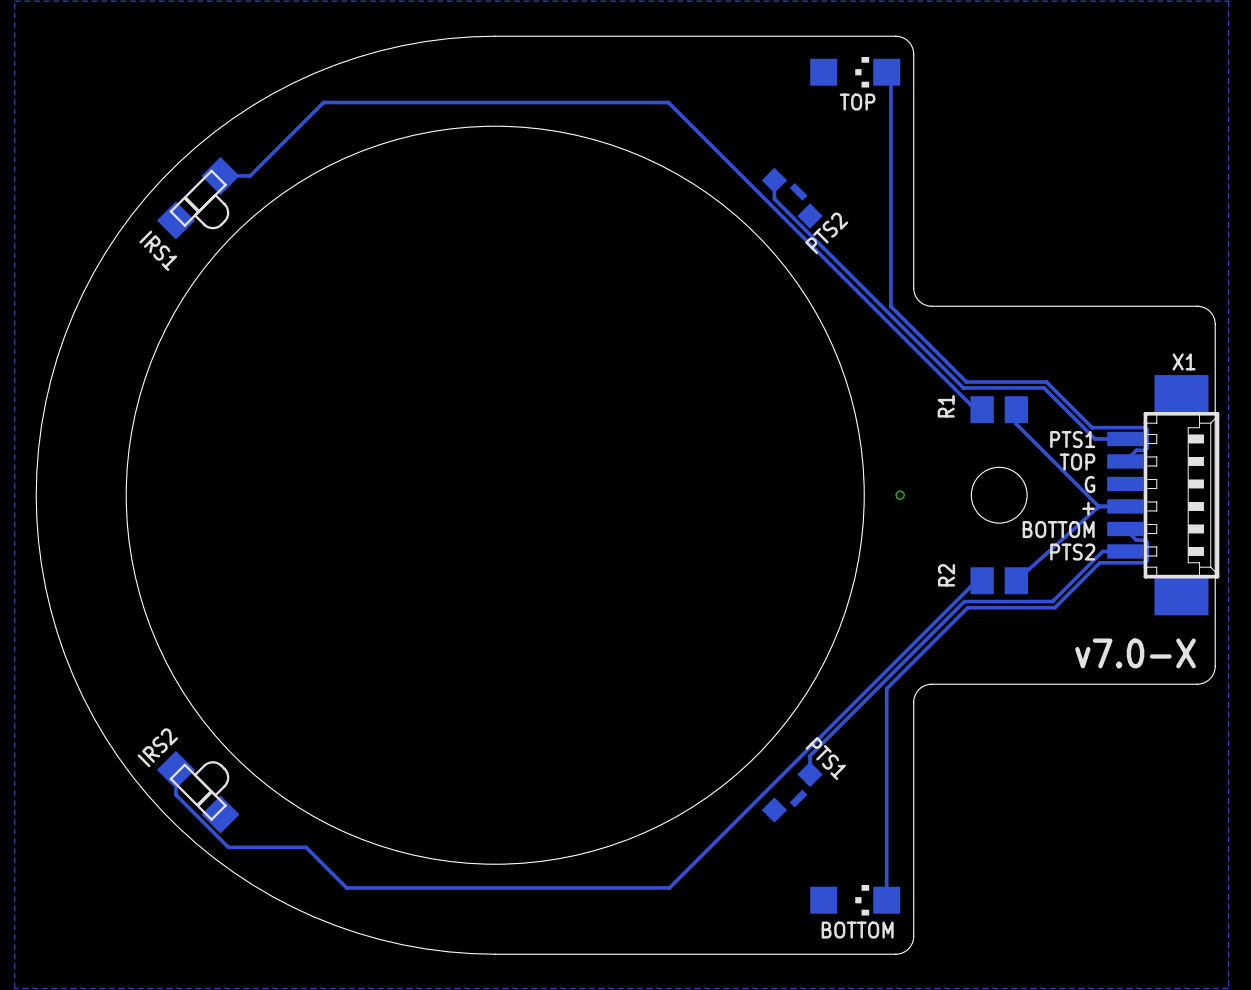
[picture p24: board ModMoPSS - IR receiver.brd from below]

Board: 2 copper layers, 65.5 x 51.0 mm, 9 parts (9 on the bottom side), 8 nets.
