RefinementReferenceCenter/Modular-MoPSS-Hardware/PCB design files/ModMoPSS - IR sender P/ModMoPSS - IR sender.brd

## EAGLE design PCB design files/ModMoPSS - IR sender P/ModMoPSS - IR sender.brd (2023-01-10)

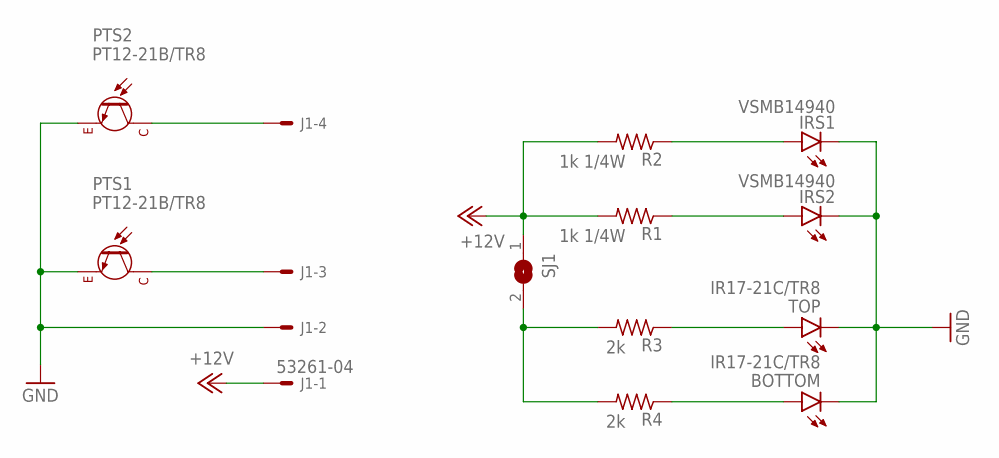
[picture p25: schematic ModMoPSS - IR sender.sch]

Parts:
BOTTOM: IR17-21C/TR8; CHIP-LED0805
IRS1, IRS2: VSMB14940
J1: 53261-04
PTS1, PTS2: PT12-21B/TR8
R1, R2: 1k 1/4W; R0805
R3, R4: 2k; R0805
SJ1: SJ
TOP: IR17-21C/TR8; CHIP-LED0805

Connections:
+12V: J1.1, R1.2, R2.2, SJ1.1
GND: BOTTOM.C, IRS1.P$2 (C), IRS2.P$2 (C), J1.2, PTS1.P$2 (E), PTS2.P$2 (E), TOP.C
unnamed: J1.3, PTS1.P$1 (C)
unnamed: IRS1.P$1 (A), R2.1
unnamed: BOTTOM.A, R4.1
unnamed: R3.1, TOP.A
unnamed: J1.4, PTS2.P$1 (C)
unnamed: R3.2, R4.2, SJ1.2
unnamed: IRS2.P$1 (A), R1.1

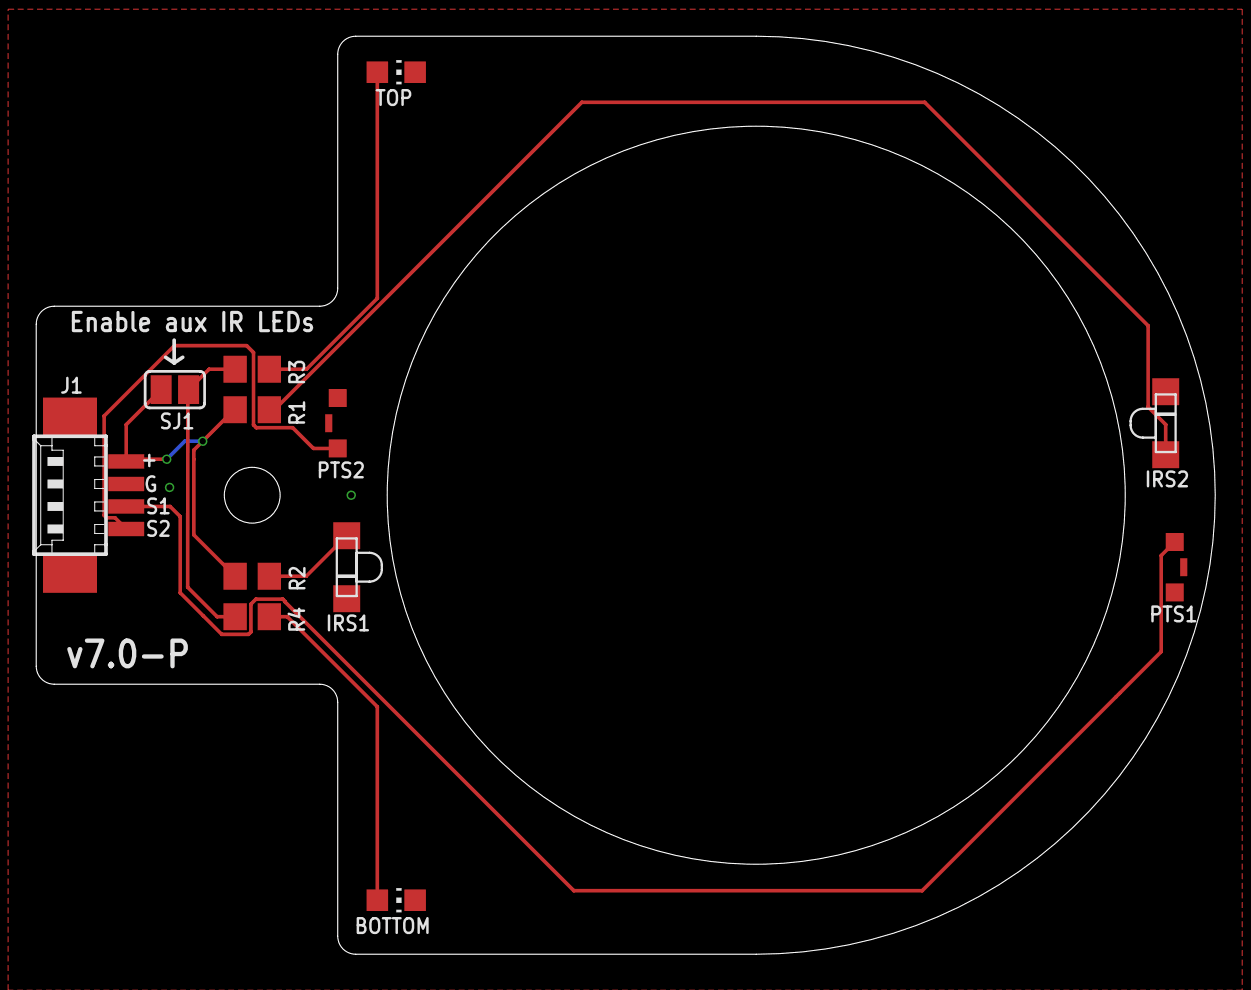
[picture p26: board ModMoPSS - IR sender.brd from above]

Board: 2 copper layers, 65.5 x 51.0 mm, 12 parts (0 on the bottom side), 9 nets.
