RefinementReferenceCenter/Modular-MoPSS-Hardware/PCB design files/ModMoPSS - door module/door_module_a.brd

## EAGLE design PCB design files/ModMoPSS - door module/door_module_a.brd (2023-01-10)

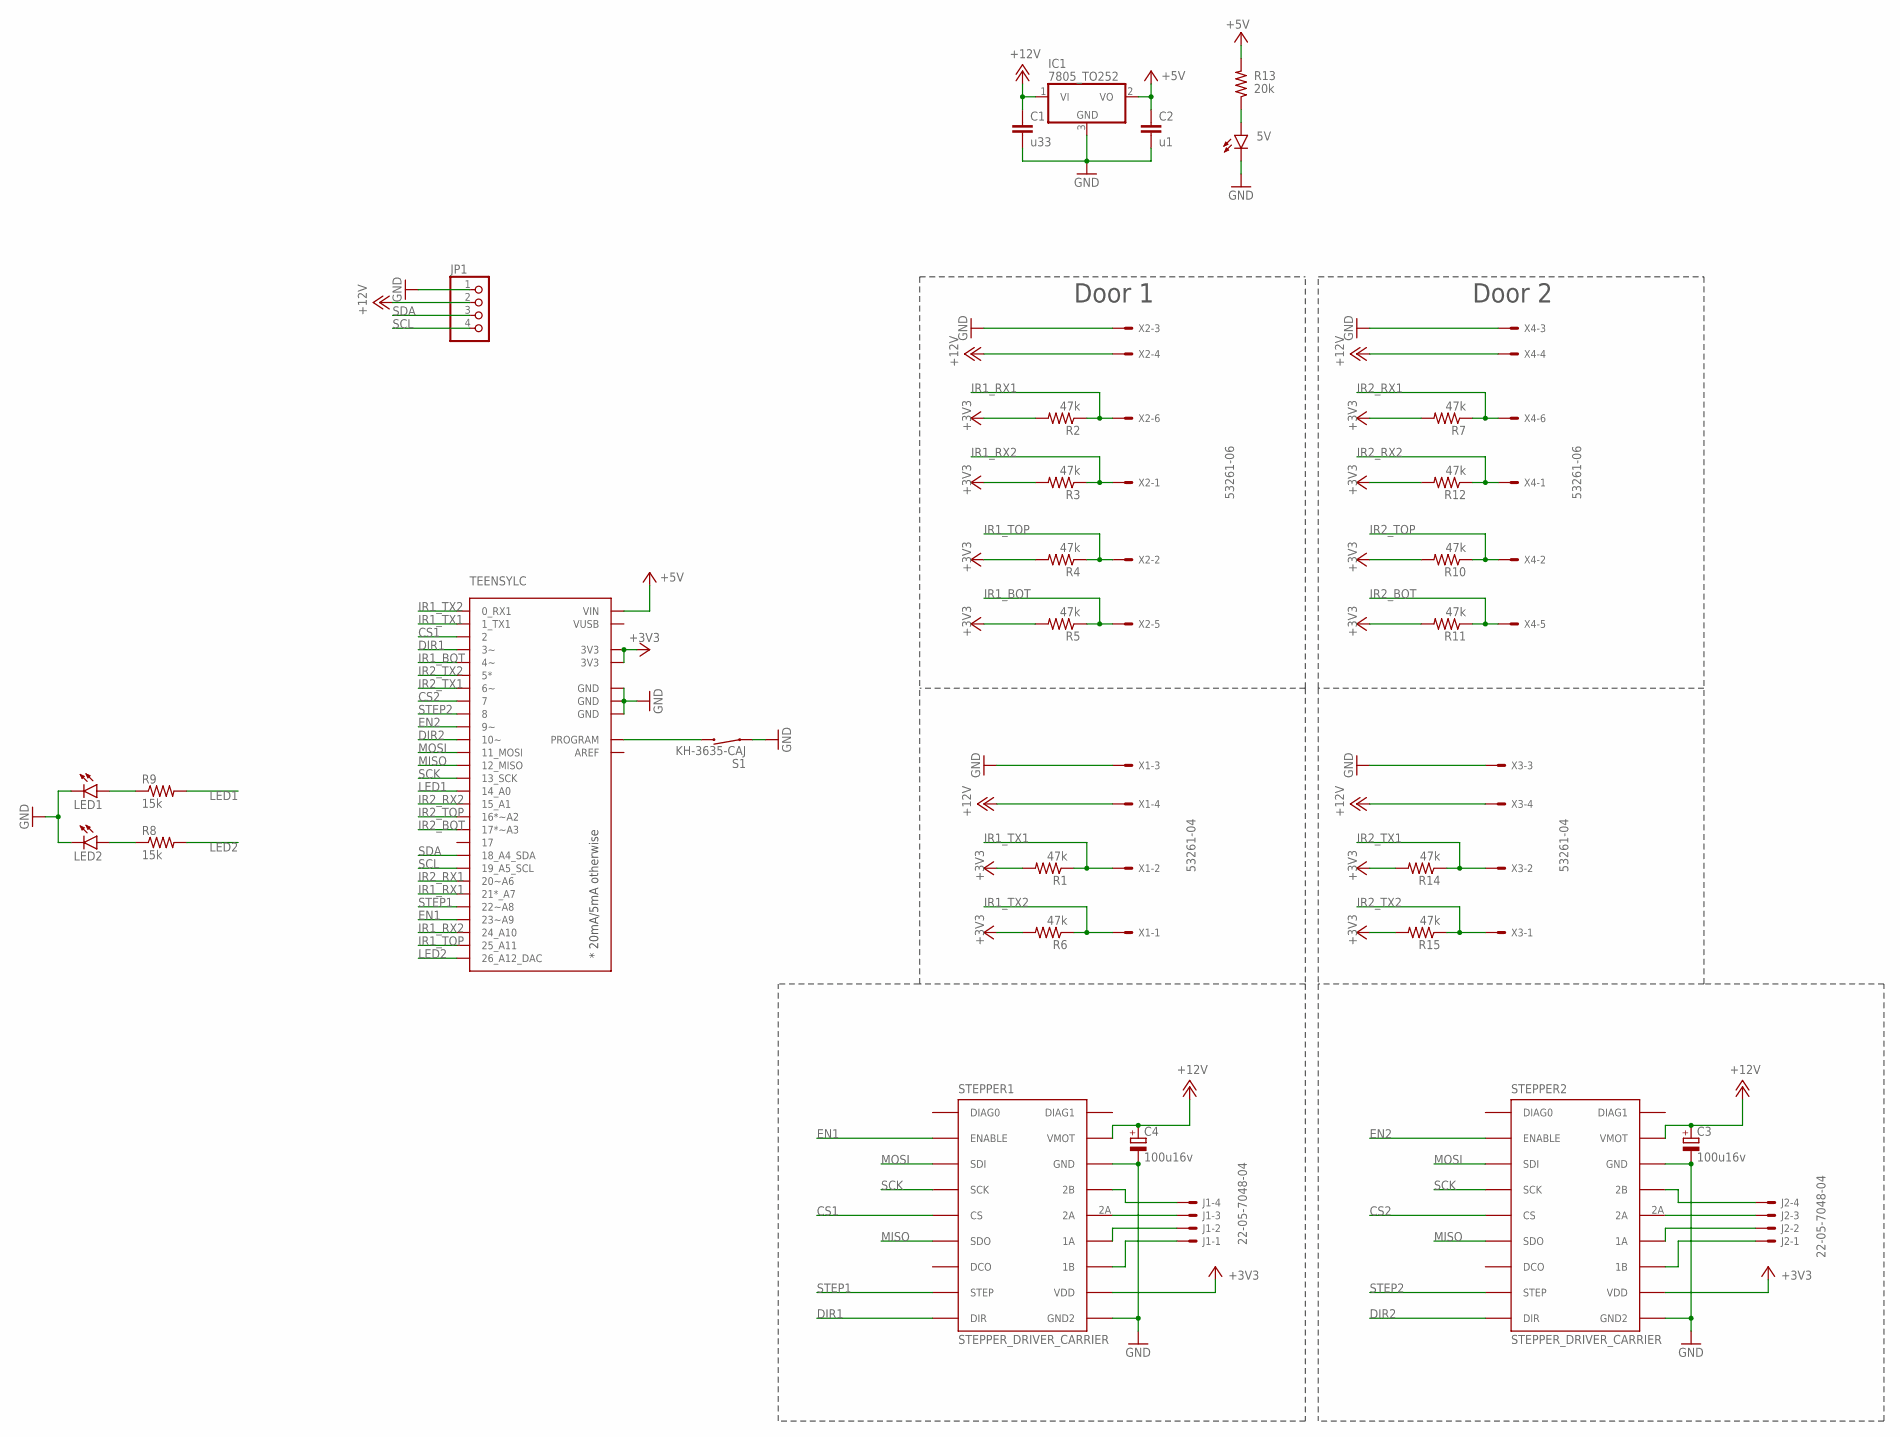
[picture p27: schematic door_module_a.sch]

Parts:
5V: LEDCHIPLED_0805; CHIPLED_0805
C1: u33; C0805
C2: u1; C0805
C3, C4: 100u16v; SMC_C
IC1: 7805_TO252; TO252
J1, J2: 22-05-7048-04; 7395-04
JP1: PINHD-1X4; 1X04
LED1, LED2: LEDCHIPLED_0805; CHIPLED_0805
R1, R2, R3, R4, R5, R6, R7, R10, R11, R12, R14, R15: 47k; R0805
R8, R9: 15k; R0805
R13: 20k; R0805
S1: KH-3635-CAJ
STEPPER1, STEPPER2: STEPPER_DRIVER_CARRIER; TMC2130_CARRIER
TEENSYLC: TEENSYLC
X1, X3: 53261-04
X2, X4: 53261-06

Connections:
+3V3: R1.2, R2.2, R3.2, R4.2, R5.2, R6.2, R7.2, R10.2, R11.2, R12.2, R14.2, R15.2, STEPPER1.VIO (VDD), STEPPER2.VIO (VDD), TEENSYLC.3V3, TEENSYLC.3V3@2 (3V3)
+5V: C2.1, IC1.2 (VO), R13.2, TEENSYLC.VIN
+12V: C1.1, C3.+, C4.+, IC1.1 (VI), JP1.2, STEPPER1.VMOT, STEPPER2.VMOT, X1.4, X2.4, X3.4, X4.4
CS1: STEPPER1.CS/CFG3 (CS), TEENSYLC.2
CS2: STEPPER2.CS/CFG3 (CS), TEENSYLC.7
DIR1: STEPPER1.DIR, TEENSYLC.3 (3~)
DIR2: STEPPER2.DIR, TEENSYLC.10 (10~)
EN1: STEPPER1.ENABLE, TEENSYLC.23 (23~A9)
EN2: STEPPER2.ENABLE, TEENSYLC.9 (9~)
GND: 5V.C, C1.2, C2.2, C3.-, C4.-, IC1.3 (GND), JP1.1, LED1.C, LED2.C, S1.P$1 (1), STEPPER1.GND, STEPPER1.GND2, STEPPER2.GND, STEPPER2.GND2, TEENSYLC.GND, TEENSYLC.GND@1 (GND), TEENSYLC.GND@2 (GND), X1.3, X2.3, X3.3, X4.3
IR1_BOT: R5.1, TEENSYLC.4 (4~), X2.5
IR1_RX1: R2.1, TEENSYLC.21 (21*_A7), X2.6
IR1_RX2: R3.1, TEENSYLC.24 (24_A10), X2.1
IR1_TOP: R4.1, TEENSYLC.25 (25_A11), X2.2
IR1_TX1: R1.1, TEENSYLC.1 (1_TX1), X1.2
IR1_TX2: R6.1, TEENSYLC.0 (0_RX1), X1.1
IR2_BOT: R11.1, TEENSYLC.17 (17*~A3), X4.5
IR2_RX1: R7.1, TEENSYLC.20 (20~A6), X4.6
IR2_RX2: R12.1, TEENSYLC.15 (15_A1), X4.1
IR2_TOP: R10.1, TEENSYLC.16 (16*~A2), X4.2
IR2_TX1: R14.1, TEENSYLC.6 (6~), X3.2
IR2_TX2: R15.1, TEENSYLC.5 (5*), X3.1
LED1: R9.2, TEENSYLC.14 (14_A0)
LED2: R8.2, TEENSYLC.26 (26_A12_DAC)
MISO: STEPPER1.SDO/CFG0 (SDO), STEPPER2.SDO/CFG0 (SDO), TEENSYLC.12 (12_MISO)
MOSI: STEPPER1.SDI/CFG1 (SDI), STEPPER2.SDI/CFG1 (SDI), TEENSYLC.11 (11_MOSI)
unnamed: LED2.A, R8.1
unnamed: LED1.A, R9.1
unnamed: S1.P$2 (2), TEENSYLC.PROG (PROGRAM)
unnamed: J1.4, STEPPER1.2B
unnamed: J1.3, STEPPER1.2A
unnamed: J1.2, STEPPER1.1A
unnamed: J2.2, STEPPER2.1A
unnamed: J1.1, STEPPER1.1B
unnamed: J2.4, STEPPER2.2B
unnamed: J2.3, STEPPER2.2A
unnamed: 5V.A, R13.1
unnamed: J2.1, STEPPER2.1B
SCK: STEPPER1.SCK/CFG2 (SCK), STEPPER2.SCK/CFG2 (SCK), TEENSYLC.13 (13_SCK)
SCL: JP1.4, TEENSYLC.19 (19_A5_SCL)
SDA: JP1.3, TEENSYLC.18 (18_A4_SDA)
STEP1: STEPPER1.STEP, TEENSYLC.22 (22~A8)
STEP2: STEPPER2.STEP, TEENSYLC.8

Notes on the sheet:
Door 1
Door 2

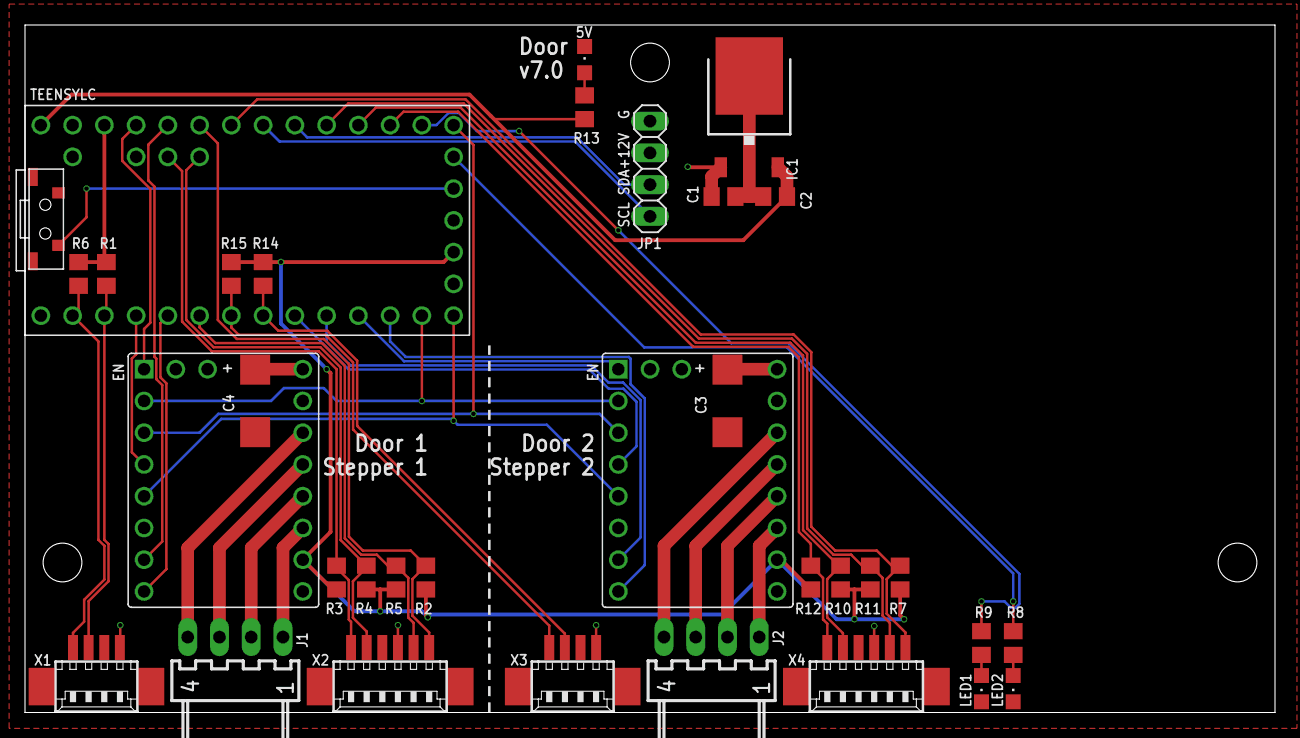
[picture p28: board door_module_a.brd from above]

Board: 2 copper layers, 100.0 x 55.0 mm, 34 parts (0 on the bottom side), 43 nets.
