RefinementReferenceCenter/Modular-MoPSS-Hardware/(commit log)

2023-11-22 Gate parts compatible with 40mm OD Acrylic tubes
    [Door 40mm.stl, Door A 40mm.stl, Door B 40mm.stl, Motorholder 40mm.stl, clamp 30mm.stl, clamp 40mm.stl, motorholder 30mm.stl]
2023-12-20 Added door for aux Power
    [RFIDcase.stl]
2025-07-09 Fix for non functional level shifting
    Update to fix non functional level shifting on DMOD and CLK pins
    [rfid.brd, rfid.sch]
2025-07-09 Fix for non functional level shifting
    Update to fix non functional level shifting on DMOD and CLK pins, GERBERS
